AlessiaRinaldi/air_analyzer/README.md

## Documentation

The full project documentation is available at:

[Air Analyzer Documentation](https://alessiarinaldi.github.io/air_analyzer/)
