AlessiaRinaldi/air_analyzer/images/air_analyzer_overview.png

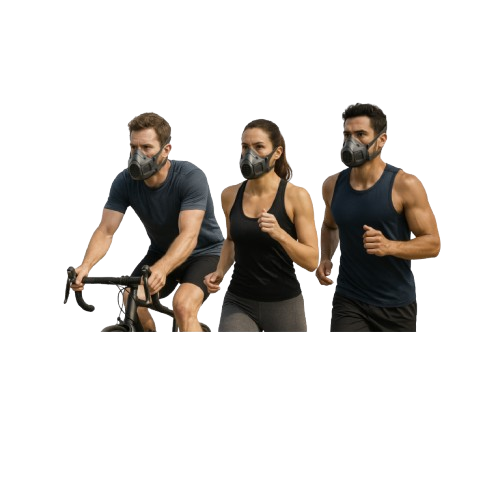
images/air_analyzer_overview.png
