AlessiaRinaldi/air_analyzer/Hardware/Breath_mask.kicad_pcb

## KiCad design Hardware/Breath_mask.kicad_pcb (2026-04-14)

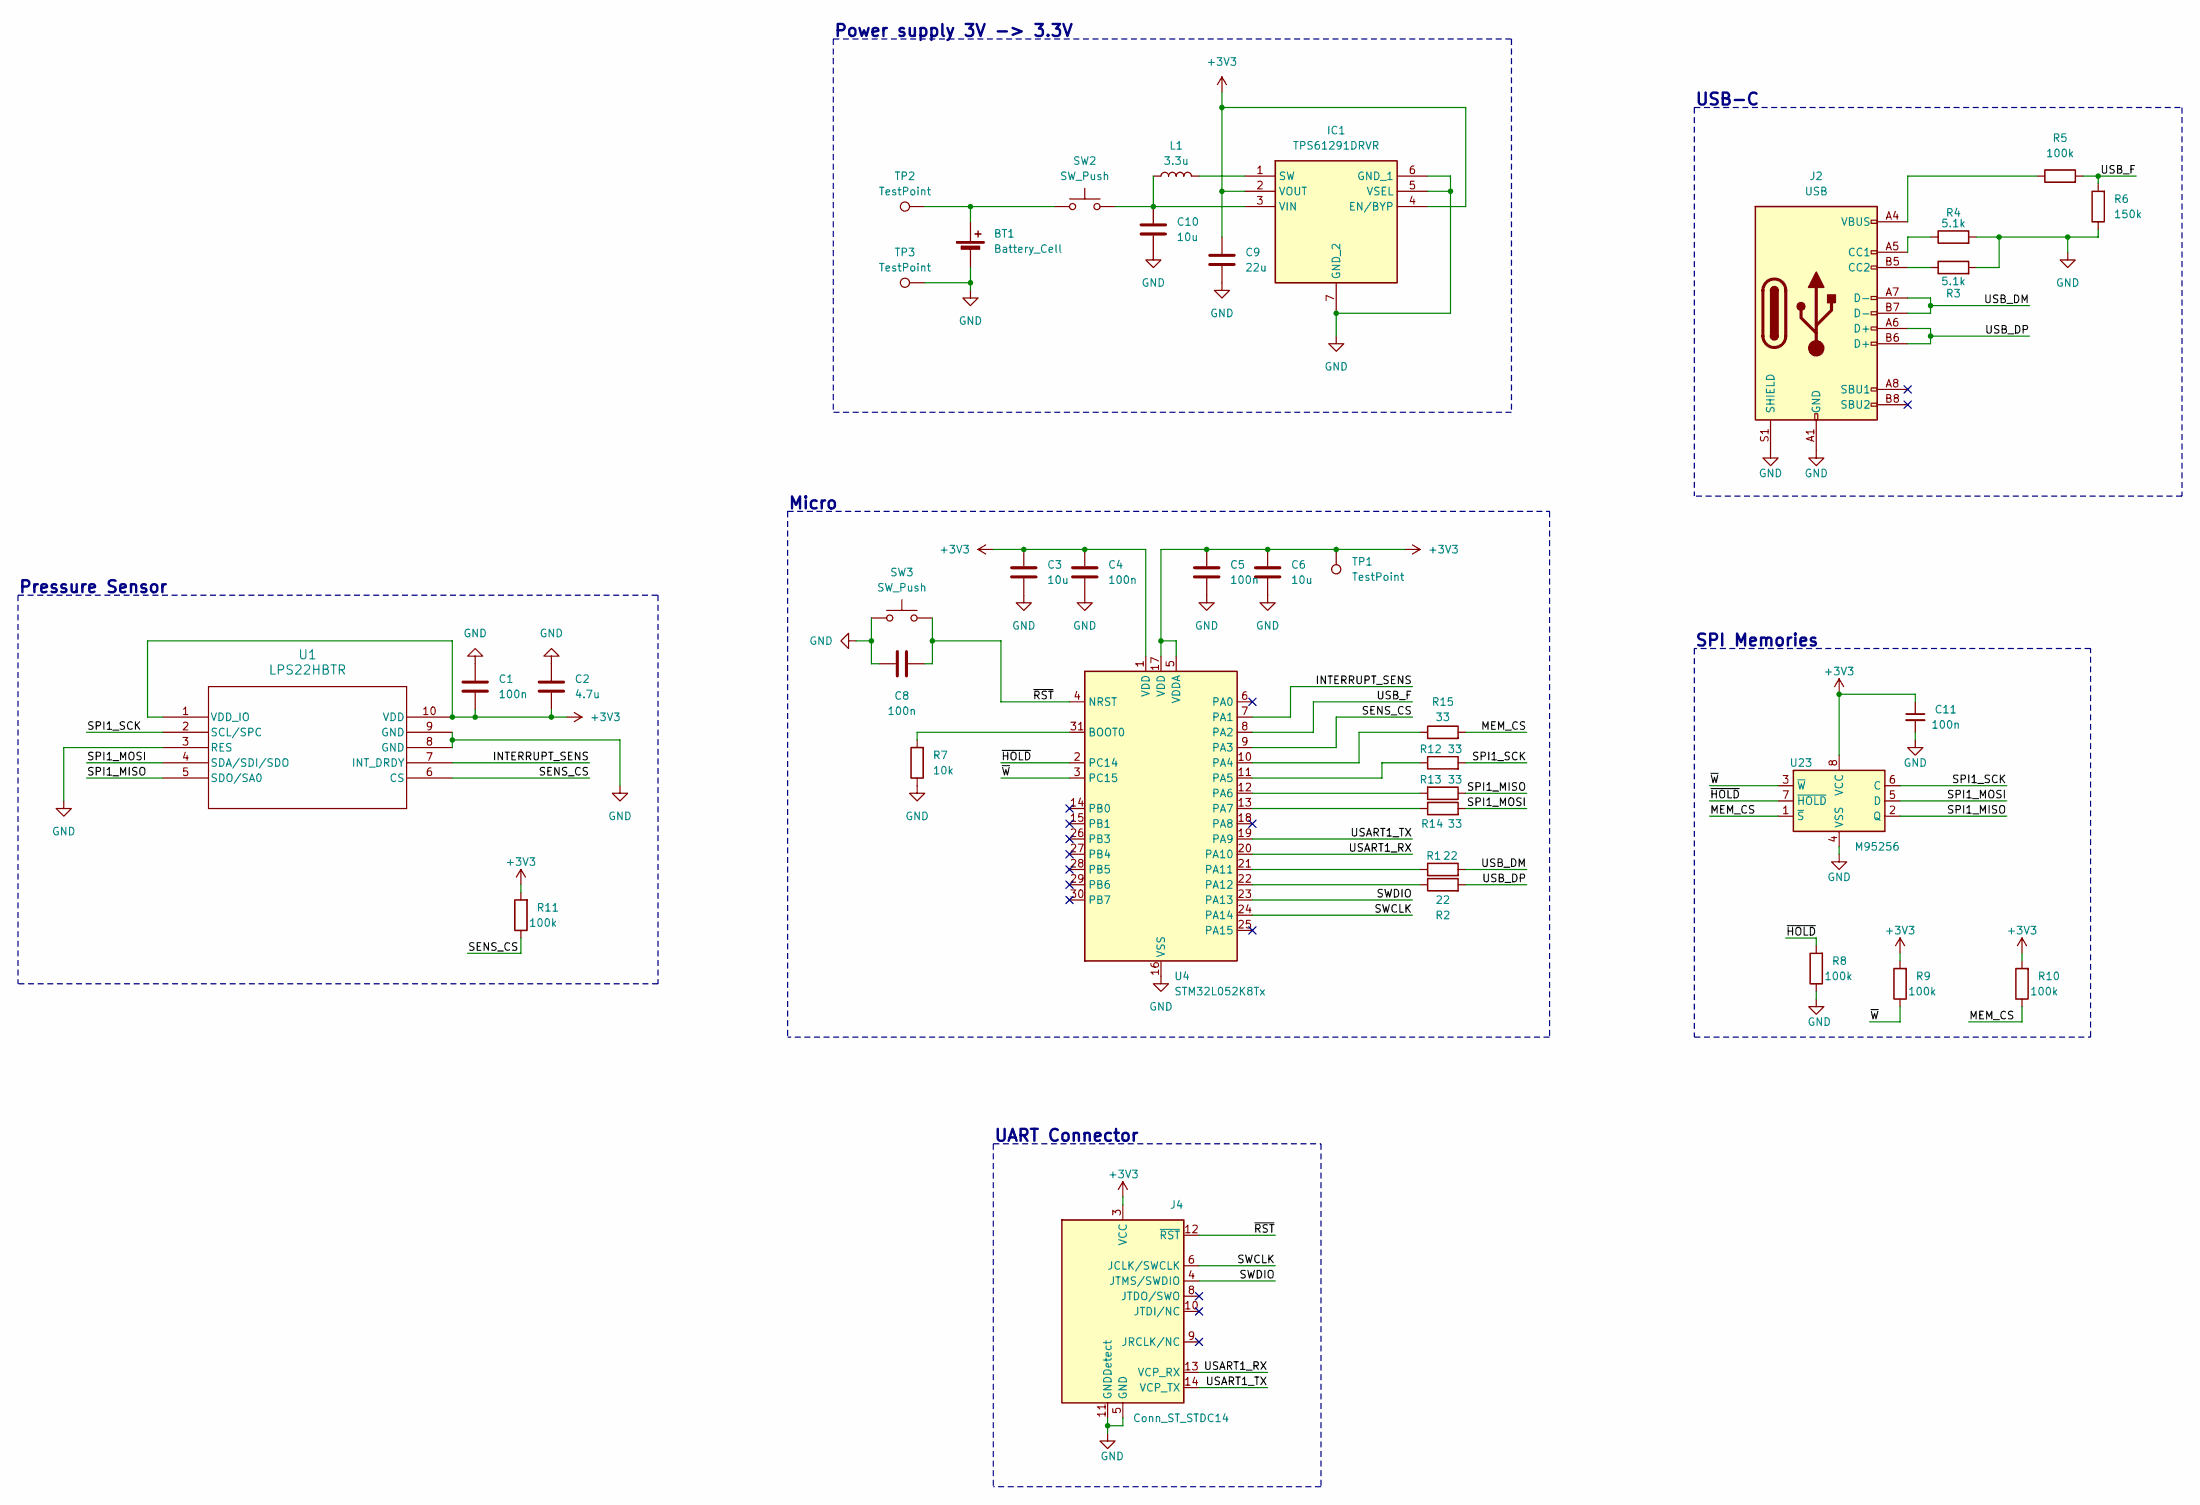
[picture p15: schematic Breath_mask.kicad_sch]

Parts:
BT1: Battery_Cell; BatteryHolder_Keystone_3034_1x20mm
C1, C4, C5, C8, C11: 100n; C_0603_1608Metric
C2: 4.7u; C_0603_1608Metric
C3, C6, C10: 10u; C_0805_2012Metric
C9: 22u; C_0805_2012Metric
IC1: TPS61291DRVR; WSON-6-1EP_2x2mm_P0.65mm_EP1x1.6mm_ThermalVias; Mouser Part Number 595-TPS61291DRVR
J2: USB; USB_C_Receptacle_HRO_TYPE-C-31-M-12
J4: Conn_ST_STDC14; SAMTEC_FTSH-107-01-L-DV-K-TR
L1: 3.3u; L_Coilcraft_LPS3314
R1, R2: 22; R_0603_1608Metric
R3, R4: 5.1k; R_0603_1608Metric
R5, R8, R9, R10, R11: 100k; R_0603_1608Metric
R6: 150k; R_0603_1608Metric
R7: 10k; R_0603_1608Metric
R12, R13, R14, R15: 33; R_0603_1608Metric
SW2: SW_Push; SW_SPDT_CK_JS102011SAQN
SW3: SW_Push; SW_Push_1P1T_XKB_TS-1187A
TP1, TP2, TP3: TestPoint; TestPoint_Pad_D1.0mm
U1: LPS22HBTR; ST_HLGA-10_2x2mm_P0.5mm_LayoutBorder3x2y
U4: STM32L052K8Tx; LQFP-32_7x7mm_P0.8mm; LCSC C222404
U23: M95256; TSSOP-8_4.4x3mm_P0.65mm

Connections:
+3V3: C1.2, C2.2, C3.2, C4.2, C5.2, C6.2, C9.1, C11.1, IC1.2 (VOUT), IC1.4 (EN/BYP), J4.3 (VCC), R9.2, R10.2, R11.2, TP1.1 (1_1), U1.1 (VDD_IO), U1.10 (VDD), U4.1 (VDD), U4.5 (VDDA), U4.17 (VDD), U23.8 (VCC)
/INTERRUPT_SENS: U1.7 (INT_DRDY), U4.7 (PA1)
/MEM_CS: R10.1, R15.2, U23.1 (~S)
/SENS_CS: R11.1, U1.6 (CS), U4.9 (PA3)
/SPI1_MISO: R13.1, U1.5 (SDO/SA0), U23.2 (Q)
/SPI1_MOSI: R14.2, U1.4 (SDA/SDI/SDO), U23.5 (D)
/SPI1_SCK: R12.2, U1.2 (SCL/SPC), U23.6 (C)
/SWCLK: J4.6 (JCLK/SWCLK), U4.24 (PA14)
/SWDIO: J4.4 (JTMS/SWDIO), U4.23 (PA13)
/USART1_RX: J4.13 (VCP_RX), U4.20 (PA10)
/USART1_TX: J4.14 (VCP_TX), U4.19 (PA9)
/USB_DM: J2.A7 (D-), J2.B7 (D-), R1.2
/USB_DP: J2.A6 (D+), J2.B6 (D+), R2.2
/USB_F: R5.2, R6.2, U4.8 (PA2)
/~HOLD: R8.2, U4.2 (PC14), U23.7 (~HOLD)
/~RST: C8.2, J4.12 (~RST), SW3.2, U4.4 (NRST)
/~W: R9.1, U4.3 (PC15), U23.3 (~W)
GND: BT1.2 (-), C1.1, C2.1, C3.1, C4.1, C5.1, C6.1, C8.1, C9.2, C10.2, C11.2, IC1.5 (VSEL), IC1.6 (GND_1), IC1.7 (GND_2), J2.A1 (GND), J2.A12 (GND), J2.B1 (GND), J2.B12 (GND), J2.S1 (SHIELD), J4.5 (GND), J4.7 (GND), J4.11 (GNDDetect), R3.2, R4.2, R6.1, R7.1, R8.1, SW3.1, TP3.1 (1_1), U1.3 (RES), U1.8 (GND), U1.9 (GND), U4.16 (VSS), U4.32 (VSS), U23.4 (VSS)
unnamed: BT1.1 (+), SW2.1, TP2.1 (1_1)
unnamed: IC1.1 (SW), L1.2
unnamed: C10.1, IC1.3 (VIN), L1.1, SW2.2
unnamed: J2.A5 (CC1), R4.1
unnamed: J2.B5 (CC2), R3.1
unnamed: J2.A4 (VBUS), J2.A9 (VBUS), J2.B4 (VBUS), J2.B9 (VBUS), R5.1
unnamed: R7.2, U4.31 (BOOT0)
unnamed: R15.1, U4.10 (PA4)
unnamed: R12.1, U4.11 (PA5)
unnamed: R13.2, U4.12 (PA6)
unnamed: R14.1, U4.13 (PA7)
unnamed: R1.1, U4.21 (PA11)
unnamed: R2.1, U4.22 (PA12)

Notes on the sheet:
Pressure Sensor
UART Connector
USB-C
Micro
SPI Memories
Power supply 3V -> 3.3V

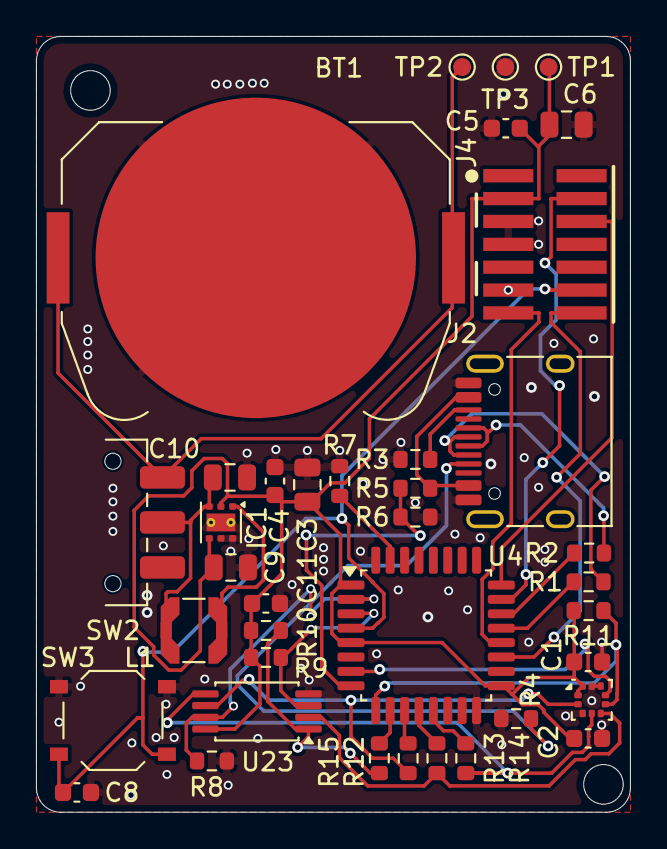
[picture p16: board Breath_mask.kicad_pcb from above]

Board: 2 copper layers, 33.0 x 43.1 mm, 38 parts (0 on the bottom side), 31 nets.
