AlessiaRinaldi/air_analyzer/firmware/Core/Src/main.c

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
/* Includes ------------------------------------------------------------------*/
#include "main.h"
#include "spi.h"
#include "usart.h"
#include "usb_device.h"
#include "gpio.h"

/* USER CODE BEGIN PD */
/* Modifica le etichette dei PIN/PORT in base a come li hai nominati su CubeMX */
#define SENSOR_CS_PORT GPIOA
#define SENSOR_CS_PIN  GPIO_PIN_4

#define MEM_CS_PORT    GPIOB
#define MEM_CS_PIN     GPIO_PIN_12

#define DATA_SIZE      4 /* Dimensione in byte dei dati del sensore */
/* USER CODE END PD */


/* USER CODE BEGIN PV */
extern SPI_HandleTypeDef hspi1; 

uint8_t sensor_tx_buf[DATA_SIZE] = {
    0x80 | 0x28,   // comando SPI read da PRESS_OUT_XL
    0x00,
    0x00,
    0x00
};

uint8_t sensor_rx_buf[DATA_SIZE] = {0};
/* USER CODE END PV */

void SystemClock_Config(void);
/**
  * @brief  The application entry point.
  * @retval int
  */
int main(void)
{

  /* MCU Configuration--------------------------------------------------------*/

  /* Reset of all peripherals, Initializes the Flash interface and the Systick. */
  HAL_Init();

  /* Configure the system clock */
  SystemClock_Config();

  /* Initialize all configured peripherals */
  MX_GPIO_Init();
  MX_SPI1_Init();
  MX_USART1_UART_Init();
  MX_USB_DEVICE_Init();
  /* USER CODE BEGIN 2 */

/* Prima tengo entrambi i chip select alti */
HAL_GPIO_WritePin(SENSOR_CS_PORT, SENSOR_CS_PIN, GPIO_PIN_SET);
HAL_GPIO_WritePin(MEM_CS_PORT, MEM_CS_PIN, GPIO_PIN_SET);

/* Configurazione LPS22HB:
   CTRL_REG1 = 0x10
   0x22 = ODR 10 Hz + BDU = 1 + SPI 4 fili
*/
uint8_t config_cmd[2] = {0x10, 0x22}; //per andare a 10 Hz

HAL_GPIO_WritePin(SENSOR_CS_PORT, SENSOR_CS_PIN, GPIO_PIN_RESET);
HAL_SPI_Transmit(&hspi1, config_cmd, 2, HAL_MAX_DELAY);
HAL_GPIO_WritePin(SENSOR_CS_PORT, SENSOR_CS_PIN, GPIO_PIN_SET);

/* Prima lettura pressione */
HAL_GPIO_WritePin(SENSOR_CS_PORT, SENSOR_CS_PIN, GPIO_PIN_RESET);
HAL_SPI_TransmitReceive_DMA(&hspi1, sensor_tx_buf, sensor_rx_buf, DATA_SIZE);

/* USER CODE END 2 */

  /* Infinite loop */
  /* USER CODE BEGIN WHILE */
  while (1)
  {
    /* USER CODE END WHILE */

    /* USER CODE BEGIN 3 */
    /* Mette la CPU in Sleep Mode finché non si verifica un Interrupt (es. fine trasferimento DMA) */
    __WFI(); 
  }
  /* USER CODE END 3 */
}

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
/* USER CODE BEGIN 4 */

/**
  * @brief  SPI Transfer Completed Callback
  * @param  hspi: SPI handle
  * @retval None
  */
void HAL_SPI_TxRxCpltCallback(SPI_HandleTypeDef *hspi)
{
  /* Verifichiamo che l'interrupt provenga dal bus SPI corretto */
  if (hspi->Instance == SPI1) 
  {
    /* I dati acquisiti sono già disponibili in 'sensor_rx_buf' */

    /* 1. Deassert del chip select del sensore di pressione */
    HAL_GPIO_WritePin(SENSOR_CS_PORT, SENSOR_CS_PIN, GPIO_PIN_SET);

    /* 2. Assert del chip select della memoria esterna */
    HAL_GPIO_WritePin(MEM_CS_PORT, MEM_CS_PIN, GPIO_PIN_RESET);

    /* 3. Scrivo i dati in memoria */
    /* (Formattazione del comando di scrittura per la memoria SPI) */
    uint8_t mem_write_cmd[4];

    mem_write_cmd[0] = 0x02;             /* comando WRITE memoria, da adattare al datasheet memoria */
    mem_write_cmd[1] = sensor_rx_buf[1]; /* PRESS_OUT_XL */
    mem_write_cmd[2] = sensor_rx_buf[2]; /* PRESS_OUT_L  */
    mem_write_cmd[3] = sensor_rx_buf[3]; /* PRESS_OUT_H  */
    
    HAL_SPI_Transmit(hspi, mem_write_cmd, 4, 10); 

    /* 4. Deassert del chip select della memoria */
    HAL_GPIO_WritePin(MEM_CS_PORT, MEM_CS_PIN, GPIO_PIN_SET);

    /* 5. Assert del chip select del sensore di pressione per preparare la prossima lettura */
    HAL_GPIO_WritePin(SENSOR_CS_PORT, SENSOR_CS_PIN, GPIO_PIN_RESET);

    /* 6. Restart del trasferimento DMA per la successiva acquisizione */
    HAL_SPI_TransmitReceive_DMA(hspi, sensor_tx_buf, sensor_rx_buf, DATA_SIZE);
  }
}

/* USER CODE END 4 */
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
