AlessiaRinaldi/air_analyzer/firmware/Core/Inc/main.h

#define NOT_HOLD_Pin GPIO_PIN_14
#define NOT_HOLD_GPIO_Port GPIOC
#define NOT_W_Pin GPIO_PIN_15
#define NOT_W_GPIO_Port GPIOC
#define INTERRUPT_SENS_Pin GPIO_PIN_1
#define INTERRUPT_SENS_GPIO_Port GPIOA
#define USBC_F_Pin GPIO_PIN_2
#define USBC_F_GPIO_Port GPIOA
#define SENS_CSS_Pin GPIO_PIN_3
#define SENS_CSS_GPIO_Port GPIOA
#define MEM_CSN_Pin GPIO_PIN_4
#define MEM_CSN_GPIO_Port GPIOA
