AlessiaRinaldi/air_analyzer/(commit log)

2026-04-01 setup schematic
    [Breath_mask.kicad_pcb, Breath_mask.kicad_sch]
2026-04-03 inizio sbroglio pcb
    [Breath_mask.kicad_pcb, Breath_mask.kicad_sch]
2026-04-13 Aggiornamento sbroglio
    [Breath_mask.kicad_pcb]
2026-04-14 dimensions fixed without traces
    [Breath_mask.kicad_pcb]
2026-04-14 Aggiornamento sbroglio con tool
    [Breath_mask.kicad_pcb]
2026-04-14 Sbroglio con tool
    [Breath_mask.kicad_pcb]
2026-04-14 errors fixed
    [Breath_mask.kicad_pcb, Breath_mask.kicad_sch]
2026-04-21 firmware: initialized
    [Breath_mask.kicad_sch]
2026-06-17 topics reordered
    [Breath_mask.kicad_pcb, Breath_mask.kicad_sch]
